KhoiDLy/Control_HASEL_Tentacle/(list of files, drawings)

Other design files:
5VV10 AND Buck Converter_PCB/5VV10 AND BUCK.SchDoc
5VV10 AND Buck Converter_PCB/5VV10 AND BUCK/5VV10 AND BUCK.PcbDoc
5VV10 AND Buck Converter_PCB/5VV10 AND BUCK/5VV10 AND BUCK.PrjPcb
5VV10 AND Buck Converter_PCB/5VV10 AND BUCK/5VV10 AND BUCK_v2_SKM.PcbDoc
5VV10 AND Buck Converter_PCB/5VV10 AND BUCK/5VV10 AND BUCK_v2_SKM.PrjPcb
5VV10 AND Buck Converter_PCB/5VV10 AND BUCK/5VV10 AND BUCK_v3_SKM.PcbDoc
